zPatch/zPatch.github.io/graphs.jpg

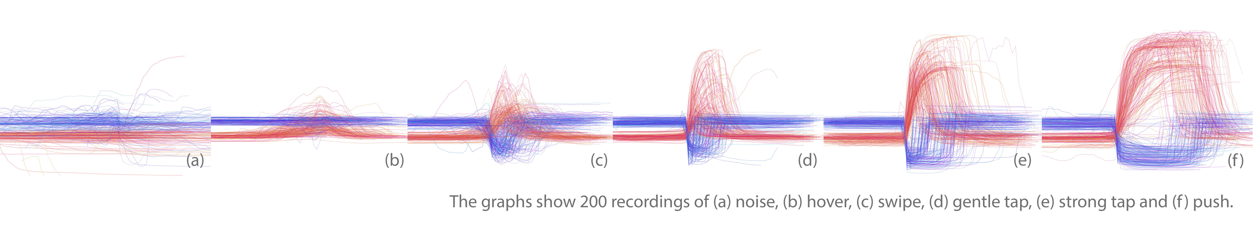
graphs.jpg
