zPatch/zPatch.github.io/(threads)

Thread 1 (2018-10-07):

Instruction / code for "Multi-Sensor Synergies"

oveddan, 2018-10-07:
In the research paper and in pictures it talks about different version of the z-patch with multi-sensors:

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

What does it mean by "four electrodes...can be pulled low sequentially" ?

It would be great if there was some sort of schematic or instructions on how to set this up, and some sample code.

fkeel, 2018-10-07:
True, those sensors are not documented. Apologies and thanks for pointing it out. I'll try to eventually get around to it.

Quick answer to your question: The sensor you speak of can be seen functioning at ~0:35 in this video: https://youtu.be/88QgGQLsvpo

The physical setup is a large conductive square at the bottom, a piezo resistive element in the centre, and four conductive pads on top, arranged like the windows logo. Like this:
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

I just threw together example code. Its not tested and I probably forgot some detail, but it should give you the basic idea:

```
int sensorValues[4];

void setup() {

  //set top four pads as output and pull them high
  for (int i = 2, i++ i < 6) {
    pinMode(i, OUTPUT);
    digitalWrite(i, HIGH);
  }

}

void loop() {

  //sequentially pull one of the top pads low
  //read from bottom pad
  for (int i = 2, i++ i < 6) {
    digitalWrite(i, LOW);
    sensorValues[i - 2] = analogRead(A0);
    digitalWrite(i, HIGH);
  }
  /*
    the sensorValues array now stores the pressure value
    as measured between the bottom pad and each top pad.
    you can now also do the capactivie proximity sensing
    but you only get a single value from it
  */
}
```

oveddan, 2018-10-07:
Thanks for your quick response, this is super helpful!  I will try to make one and document it :)

oveddan, 2018-10-07:
@fkeel I'm not entirely clear how the capacitive proximity sensing works, as it's a bit challenging to understand how the guts of the [capactiveRead](https://github.com/zPatch/zPatch.github.io/blob/master/ArduinoCode/fabricSensor/fabricSensor.ino#L65) function works.

Assuming I just copy and paste the code for that function, what pins would I be passing to it as arguments?  Would it be the one for the bottom piece and any of the top pieces?

fkeel, 2018-10-07:
@oveddan

Sorry, its been a while. You could do: capacitiveRead(A0, 2, 10)

I wrote the capacitiveRead function to accept two pins as I wanted the whole thing symmetrical, so that it doesn't matter which way they are plugged into the Arduino. With the 2 by 2 setup that no longer really makes sense.

You could also try this, it should be a tad faster and easier to understand:

```
int simpleCapacitiveRead(A0, 10) { //reads the capacitance from a single pin
  int capacitanceA = 0; //capacitance measured at single reading
  int capacitance = 0; //overall capacitance measured

  for (int i = 0; i < number; i++) { //read multple times, because the signal is messy

// this part charges an internal capacitor connected to the ADC
// its discharge speed depends on the capacitance of the pin
// this allows us to infer touch/proximity

    pinMode(pinA, INPUT_PULLUP);
    ADMUX |=   0b11111;
    ADCSRA |= (1 << ADSC); //start conversion
    while (!(ADCSRA & (1 << ADIF))); //wait for conversion to finish
    ADCSRA |= (1 << ADIF); //reset the flag
    pinMode(pinA, INPUT);
    capacitanceA = analogRead(pinA);

    capacitance = capacitance + capacitanceA; //get the sum of all readings (I could have also just done average)

  }
  return capacitance;
}
```

again, the above code is not tested.

fkeel, 2018-10-08:
(I tweaked a brainfart above and change variable names to make more sense, just FYI)

oveddan, 2018-10-08:
Awesome, I've just made the sensor, looking forward to trying the above.  Let you know if I run into any issues!
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

oveddan, 2018-10-08:
Nevermind...the above doesnt seem to work anymore :(

oveddan, 2018-10-09:
@fkeel disregard the above, but I'm onto what the issue is.  If I have the below code:

```c
const int BOTTOM_SENSOR = A0;
const int TOP_SENSORS[] = {A1, A2, A3, A4};
const int numSensors = 4;
float k = 0.2; // this adjusts the low-pass filter:
               // 0 == no signal
               // 0.001 == very aggressive (slow but steady)
               // 0.999 == not aggressive at all (fast but noisy)
               // 1 == no filter

int sensorValues[4];
int baseline;
int prevCapValues;

void setup() {

  Serial.begin(9600);
  delay(50);
    //set top four pads as output and pull them high
  for (int i = 0; i< 4; i++) {
    pinMode(TOP_SENSORS[i], OUTPUT);
    digitalWrite(TOP_SENSORS[i], HIGH);
  }
  baseline = capacitiveRead(10); //set the baseline for capacitive readings
  delay(50);
}

void loop() {
  int rawCapacitance = capacitiveRead(10);
  rawCapacitance = (rawCapacitance - baseline); //baseline capacitance value
  int capValues = prevCapValues + (k * (rawCapacitance - prevCapValues)); //filter capacitive value
  prevCapValues = capValues; //for filtering

  Serial.println(capValues);
  /*
    the sensorValues array now stores the pressure value
    as measured between the bottom pad and each top pad.
    you can now also do the capactivie proximity sensing
    but you only get a single value from it
  */

  delay(5); // (so as not to completely flood the serial port)
}

int capacitiveRead(int number) {
  int pinA = A0;
  int pinB = A1;
  int capacitanceA = 0;
  int capacitanceB = 0;
  int capacitance = 0;

  for (int i = 0; i < number; i++) {
    pinMode(pinA, INPUT);
    pinMode(pinB, INPUT_PULLUP);
    ADMUX |=  0b11111;
    ADCSRA |= (1 << ADSC); //start conversion
    while (!(ADCSRA & (1 << ADIF))); //wait for conversion to finish
    ADCSRA |= (1 << ADIF); //reset the flag
    pinMode(pinB, INPUT);
    capacitanceB = analogRead(pinB);

    pinMode(pinB, INPUT);
    pinMode(pinA, INPUT_PULLUP);
    ADMUX |=   0b11111;
    ADCSRA |= (1 << ADSC); //start conversion
    while (!(ADCSRA & (1 << ADIF))); //wait for conversion to finish
    ADCSRA |= (1 << ADIF); //reset the flag
    pinMode(pinA, INPUT);
    capacitanceA = analogRead(pinA);

    capacitance = capacitance + capacitanceA + capacitanceB;

  }
  return capacitance;
}
```

The capacitive reading always has a nearly constant value, regardless of the hover.

If I comment out the lines:
```
    pinMode(TOP_SENSORS[i], OUTPUT);
    digitalWrite(TOP_SENSORS[i], HIGH);
```

Then this solves the issue and it works as expected.  What state should the pins be in before checking the capacitance?

oveddan, 2018-10-09:
Alright I seemed to figure it out!  I had to set the pinMode back to INPUT, so for example in the setup:

```c
 for (int i = 0; i< 4; i++) {
    pinMode(TOP_SENSORS[i], OUTPUT);
    digitalWrite(TOP_SENSORS[i], HIGH);
    pinMode(TOP_SENSORS[i], INPUT);
  }
```

This somehow fixed everything.  My final code looks like:

```c
const int BOTTOM_SENSOR = A0;
const int TOP_SENSORS[] = {A1, A2, A3, A4};
const int numSensors = 4;
float k = 0.2; // this adjusts the low-pass filter:
               // 0 == no signal
               // 0.001 == very aggressive (slow but steady)
               // 0.999 == not aggressive at all (fast but noisy)
               // 1 == no filter

int sensorValues[4];
int baseline;
int prevCapValues;

void setup() {

  Serial.begin(9600);
  delay(50);
    //set top four pads as output and pull them high
  for (int i = 0; i< 4; i++) {
    pinMode(TOP_SENSORS[i], OUTPUT);
    digitalWrite(TOP_SENSORS[i], HIGH);
    pinMode(TOP_SENSORS[i], INPUT);
  }
  baseline = capacitiveRead(10); //set the baseline for capacitive readings
  delay(50);
  // // set top four pads as output and pull them high
  // for (int i = 0; i < 4; i++) {
  //   pinMode(TOP_SENSORS[i], OUTPUT);
  //   digitalWrite(TOP_SENSORS[i], HIGH);
  // }
}

void loop() {

  // sequentially read the push strength from each pad
  for (int i = 0; i< numSensors; i++) {
    int sensorValue = pushRead(TOP_SENSORS[i], 3);
    Serial.print(sensorValue);
    Serial.print(" ");
  }

  // get single capacitance value which represents the hover effect
  int rawCapacitance = capacitiveRead(10);
  rawCapacitance = (rawCapacitance - baseline); //baseline capacitance value
  int capValues = prevCapValues + (k * (rawCapacitance - prevCapValues)); //filter capacitive value
  prevCapValues = capValues; //for filtering

  Serial.println(capValues);

  delay(5); // (so as not to completely flood the serial port)
}

int pushRead(int pin, int numSamples) {
  int resistance;
  pinMode(pin, OUTPUT);

  for (int i = 0; i < numSamples; i++) {
    digitalWrite(pin, LOW);
    pinMode(BOTTOM_SENSOR, INPUT_PULLUP);
    resistance += analogRead(BOTTOM_SENSOR);
    digitalWrite(pin, HIGH);
  }
  pinMode(pin, INPUT);
  return resistance / numSamples;
}

int capacitiveRead(int number) {
  int pinA = A0;
  int pinB = A1;
  int capacitanceA = 0;
  int capacitanceB = 0;
  int capacitance = 0;

  for (int i = 0; i < number; i++) {
    pinMode(pinA, INPUT);
    pinMode(pinB, INPUT_PULLUP);
    ADMUX |=  0b11111;
    ADCSRA |= (1 << ADSC); //start conversion
    while (!(ADCSRA & (1 << ADIF))); //wait for conversion to finish
    ADCSRA |= (1 << ADIF); //reset the flag
    pinMode(pinB, INPUT);
    capacitanceB = analogRead(pinB);

    pinMode(pinB, INPUT);
    pinMode(pinA, INPUT_PULLUP);
    ADMUX |=   0b11111;
    ADCSRA |= (1 << ADSC); //start conversion
    while (!(ADCSRA & (1 << ADIF))); //wait for conversion to finish
    ADCSRA |= (1 << ADIF); //reset the flag
    pinMode(pinA, INPUT);
    capacitanceA = analogRead(pinA);

    capacitance = capacitance + capacitanceA + capacitanceB;

  }
  return capacitance;
}
```

When I have  more time will try to figure out how to get the simpleCapacitiveRead function working

fkeel, 2018-10-09:
What is the 'capacitiveRead' function you're using, is it what you posted
before?
Is it giving you a hover-measure? Why do you not want to use it?
Just glancing at your code makes me think everything looks good.

(I don't have anything to test at the moment).

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

--
Paul Strohmeier - PhD candidate, University of Copenhagen

           [group] body-ui.eu
           [web] paulstrohmeier.info
           [mail] paul.strohmeier@gmail.com

Thread 2 (2021-06-02):

Compilation error ADMUX variable

Daara-S, 2021-06-02:
Hi,

I'm getting an error in compiling the sensor code due to variables not being declared (ADMUX, ADCSRA, ADSC, ADIF)
I'm compiling for the Arduino Nano 33 BLE Sense, with a single zPatch connected.

Below is the full error message:

Arduino: 1.8.13 (Windows 10), TD: 1.53, Board: "Arduino Nano 33 BLE"

C:\Users\daara\Documents\Arduino\e-textiles\zPatch\zPatch.ino: In function 'int capacitiveRead(int, int, int)':

zPatch:73:5: error: 'ADMUX' was not declared in this scope

     ADMUX |=   0b11111;

     ^~~~~

zPatch:74:5: error: 'ADCSRA' was not declared in this scope

     ADCSRA |= (1 << ADSC); //start conversion

     ^~~~~~

C:\Users\daara\Documents\Arduino\e-textiles\zPatch\zPatch.ino:74:5: note: suggested alternative: 'ADC0_0'

     ADCSRA |= (1 << ADSC); //start conversion

     ^~~~~~

     ADC0_0

zPatch:74:21: error: 'ADSC' was not declared in this scope

     ADCSRA |= (1 << ADSC); //start conversion

                     ^~~~

C:\Users\daara\Documents\Arduino\e-textiles\zPatch\zPatch.ino:74:21: note: suggested alternative: 'DEC'

     ADCSRA |= (1 << ADSC); //start conversion

                     ^~~~

                     DEC

zPatch:75:29: error: 'ADIF' was not declared in this scope

     while (!(ADCSRA & (1 << ADIF))); //wait for conversion to finish

                             ^~~~

C:\Users\daara\Documents\Arduino\e-textiles\zPatch\zPatch.ino:75:29: note: suggested alternative: 'DIR'

     while (!(ADCSRA & (1 << ADIF))); //wait for conversion to finish

                             ^~~~

                             DIR

zPatch:76:21: error: 'ADIF' was not declared in this scope

     ADCSRA |= (1 << ADIF); //reset the flag

                     ^~~~

C:\Users\daara\Documents\Arduino\e-textiles\zPatch\zPatch.ino:76:21: note: suggested alternative: 'DIR'

     ADCSRA |= (1 << ADIF); //reset the flag

                     ^~~~

                     DIR

exit status 1

'ADMUX' was not declared in this scope

This report would have more information with
"Show verbose output during compilation"
option enabled in File -> Preferences.
